mbuesch/pbwake/schematics/pbwake-attiny/pbwake.pdf

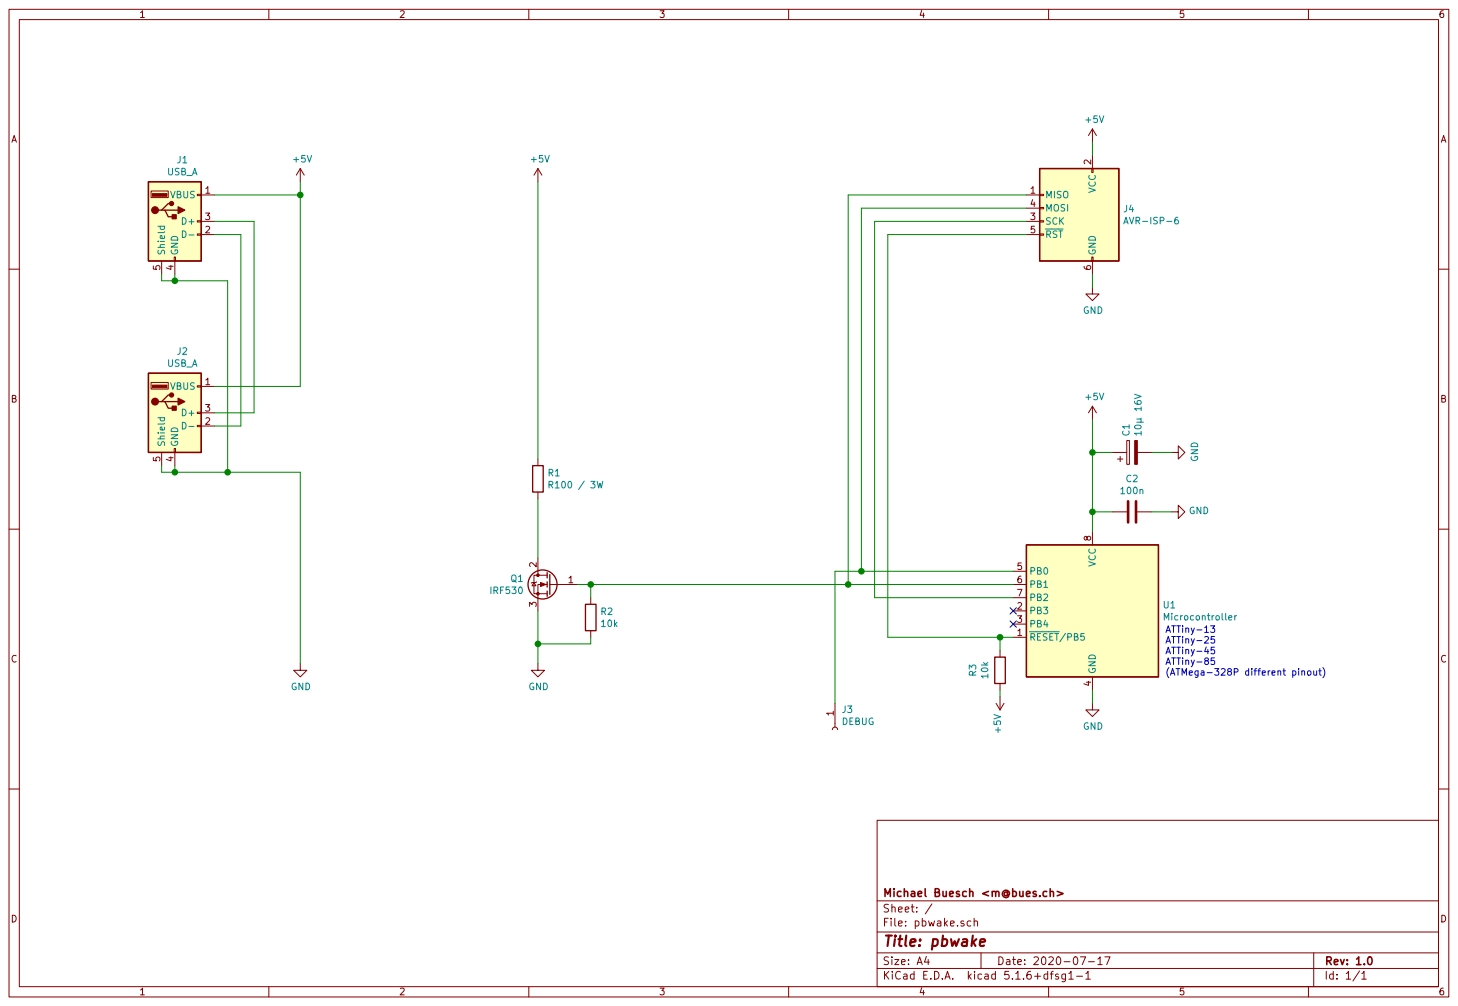
[picture p3: page 1]
