mbuesch/pbwake/schematics/pbwake-attiny/pbwake.kicad_pcb

## KiCad design FBF_STM32CoreBoard.sch


Parts:
C1: 10uF/Tantalum
C2: 22uF/Tantalum
C3, C4: 10pf/0603/5%
C5, C6: 20pf/0603/5%
C7: 10uF/10%/6032/Tantalum
C8: 100nf/5%/0603
C9, C10, C11, C12, C13: 100nF/5%/0603
C14, C15, C16, C17, C18: CP
D1: LED_RED_Power
D2, D3: LED_RED_BLUE
FB1: FILTER
J1: SWD_STM32
J2: DB9
P1: CONN_02X03
R1, R3, R4: 10k/1%/0603
R2: R
R5, R6: 10K/1%/0603
SW1: SW_PUSH
U1: NCP1117ST33T3G
U2: STM32F103RT6
U3: SP3232E
Y1: 327680HZ
Y2: 8MHZ/5032

Connections:
+3V3: C2.2, C7.1, C9.2, C10.1, C11.1, C12.1, C13.1, C18.1, FB1.1, J1.5 (+3V3), P1.1, P1.2, R1.2, R3.2, R4.2, U1.2 (VO), U2.1 (VBAT), U2.19 (VDD_4), U2.32 (VDD_1), U2.48 (VDD_2), U2.64 (VDD_3), U3.16 (Vcc)
+5V: C1.2, U1.3 (VI)
BOOT0: R5.2, U2.60 (BOOT0)
BOOT1: R6.1, U2.28 (PB2)
GND: C1.1, C2.1, C3.2, C4.2, C5.2, C6.2, C7.2, C8.2, C9.1, C10.2, C11.2, C12.2, C13.2, C16.1, C17.2, C18.2, D1.1 (K), J1.4 (GND), J2.5, P1.5, P1.6, SW1.1, U1.1 (GND), U2.12 (VSSA), U2.18 (VSS_4), U2.31 (VSS_1), U2.47 (VSS_2), U2.63 (VSS_3), U3.15 (GND)
LED_SHOW_RUN: D2.1 (K), D3.1 (K)
NRST: J1.1 (RST), R2.2
NRST2: C8.1, R2.1, SW1.2, U2.7 (NRST)
unnamed: C3.1, U2.3 (PC14-OSC32_IN), Y1.1
unnamed: C4.1, U2.4 (PC15-OSC32_OUT), Y1.2
unnamed: C5.1, U2.5 (OSC_IN), Y2.1
unnamed: C6.1, U2.6 (OSC_OUT), Y2.2
unnamed: C14.1, U3.1 (C1+)
unnamed: C14.2, U3.3 (C1-)
unnamed: C15.1, U3.4 (C2+)
unnamed: C15.2, U3.5 (C2-)
unnamed: C16.2, U3.6 (V-)
unnamed: C17.1, U3.2 (V+)
unnamed: D2.2 (A), R3.1
unnamed: D3.2 (A), R4.1
unnamed: P1.3, R5.1
unnamed: P1.4, R6.2
PA0: U2.14 (PA0-WKUP)
PA1: U2.15 (PA1)
PA2: U2.16 (PA2)
PA3: U2.17 (PA3)
PA4: U2.20 (PA4)
PA5: U2.21 (PA5)
PA6: U2.22 (PA6)
PA7: U2.23 (PA7)
PA8: U2.41 (PA8)
PA11: U2.44 (PA11)
PA12: U2.45 (PA12)
PA15: U2.50 (PA15)
PB0: U2.26 (PB0)
PB1: U2.27 (PB1)
PB3: U2.55 (PB3)
PB4: U2.56 (PB4)
PB5: U2.57 (PB5)
PB6: U2.58 (PB6)
PB7: U2.59 (PB7)
PB8: U2.61 (PB8)
PB9: U2.62 (PB9)
PB10: U2.29 (PB10)
PB11: U2.30 (PB11)
PB12: U2.33 (PB12)
PB13: U2.34 (PB13)
PB14: U2.35 (PB14)
PB15: U2.36 (PB15)
PC0: U2.8 (PC0)
PC1: U2.9 (PC1/ADC123_IN11)
PC2: U2.10 (PC2/ADC123_IN12)
PC3: U2.11 (PC3/ADC123_IN13)
PC4: U2.24 (PC4)
PC5: U2.25 (PC5)
PC6: U2.37 (PC6)
PC7: U2.38 (PC7)
PC8: U2.39 (PC8)
PC9: U2.40 (PC9)
PC10: U2.51 (PC10)
PC11: U2.52 (PC11)
PC12: U2.53 (PC12)
PC13: U2.2 (PC13-TAMPER-RTC)
PD2: U2.54 (PD2)
POWER_LED: D1.2 (A), R1.1
R1IN: J2.3, U3.13 (R1IN)
R1OUT: U2.43 (PA10), U3.12 (R1OUT)
SWCLK: J1.2 (SWCLK), U2.49 (PA14)
SWDIO: J1.3 (SWDIO), U2.46 (PA13)
T1IN: U2.42 (PA9), U3.11 (T1IN)
T1OUT: J2.2, U3.14 (T1OUT)
VDDA: FB1.2, U2.13 (VDDA)
