mbuesch/pbwake/(commit log)

2020-07-04 Disable debug pin, if not debugging
2020-07-04 Add schematics
    [pbwake.kicad_pcb, pbwake.sch]
2020-07-10 attiny: Fix pwm output pin assignment
    [main.c]
2020-07-15 load: Start with low-phase, if a reboot happened
    [load.c, watchdog.c]
2020-07-17 load: Use short low phase after error reboots
    [load.c]
2020-07-17 schematics: Add uc types
    [pbwake.sch]
2020-07-17 Move schematics
    [pbwake.kicad_pcb, pbwake.sch]
